osmocom/osmo-bts-amp/datasheets/fischer_wag100.jpg

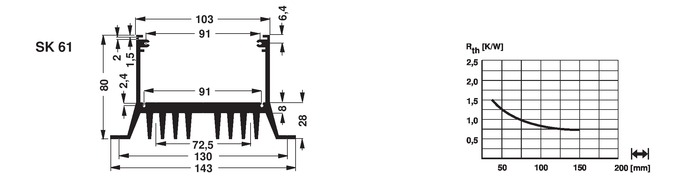
datasheets/fischer_wag100.jpg
