osmocom/osmo-bts-amp/bom/bom.ods

Id | Designator | Package | Quantity | Value | Manufacturer | Supplier | Supplier Ref | SR-Systems | Link
1 | C6, C11, C18 | C-EU_0603 | 3 | 10p / RF |  | SR-Systems | 712-1308-1-ND
2 | C3, C4 | C-EU_0603 | 2 | 15p / RF |  | SR-Systems | 712-1318-1-ND
3 | C5 | C-EU_0603 | 1 | 100p / RF |  | SR-Systems | 712-1310-1-ND
4 | C1, C2, C13, C14, C19 | C-EU_0603 | 5 | 10n |  | SR-Systems | 399-1091-1-ND
5 | C7, C8, C9, C10, C17 | C-EU_0603 | 5 | DNP
6 | C12, C15, C20 | C-EU_0603 | 3 | 100n |  | SR-Systems | 478-1239-1-ND
7 | C16, C21 | C-EU_0805 | 2 | 2.2u |  | Digikey | 587-1286-1-ND
8 | C22, C24, C25, C26 | CPOL-EUSMCA | 4 | 10u / 1ohm |  | Digikey | 478-1751-1-ND
9 | C23 | CPOL-EUSMCA | 1 | 22u / 1ohm |  | Digikey | 718-1304-1-ND
10 | D1, D2, D3, D4, D5 | SOD882 | 5 | PESD5V0F1BL | NXP | Digikey | 568-7344-1-ND |  | http://www.nxp.com/documents/data_sheet/PESD5V0F1BL.pdf
11 | FB1, FB2 | FBEAD_1206 | 2 | 3A |  | Digikey | 240-2412-1-ND
12 | FB3, FB4 | FBEAD_0603 | 2 | 500mA |  | Digikey | 445-6405-1-ND
13 | FLT1 | RDUP_4415 | 1 | RDUP-1710-1785M-1805-1880M-4415-3W-S-CA-J2 | Raditek | sysmocom |  | DNP
14 | FLT2, FLT3 | DCC6C | 2 | B3832 | Epcos | sysmocom |  |  | http://www.epcos.com/inf/40/ds/mc/B3832.pdf
15 | J1, J2 | 2x1 / 2.54 | 2 | '640456-2 | TE | Digikey | A1921-ND
16 | L1 | L-EU_0603 | 1 | 27n |  | Digikey | M8486CT-ND
17 | L2, L3 | L-EU_0603 | 2 | 10n |  | Digikey | M8484CT-ND
18 | R1 | R-EU_0603 | 1 | DNP
19 | ANT, TX_IN, RX_OUT | SMA-F-S-TH | 3 | SMA | Molex | Digikey | WM5537-ND | DNP | http://www.molex.com/pdm_docs/sd/732512201_sd.pdf
20 | RX_OUT_UFL, TX_IN_UFL | HRS_UFL | 2 | U.FL | Hirose | Digikey
21 | U1 | QFN2020_5x5 | 1 | RF3865 | RFMD | sysmocom |  |  | www.rfmd.com/CS/Documents/3865DS.pdf
22 | U2 | ALM32x20 | 1 | ALM32220 | Avago | Farnell |  |  | http://www.avagotech.com/docs/AV02-1146EN
23 | U3 | TO220BV | 1 | MIC29301-5.0WT | Micrel | Digikey | 576-2225-ND |  | http://www.micrel.com/_PDF/mic29150.pdf
24 | RF Shield Frame |  | 1 | 36103255 | Wuerth | Digikey | 732-2489-ND
25 | RF Shield Cover |  | 1 | 36003250 | Wuerth | Digikey | 732-2491-ND
