osmocom/osmo-bts-amp/design/osmo-bts-lna_placement.pdf

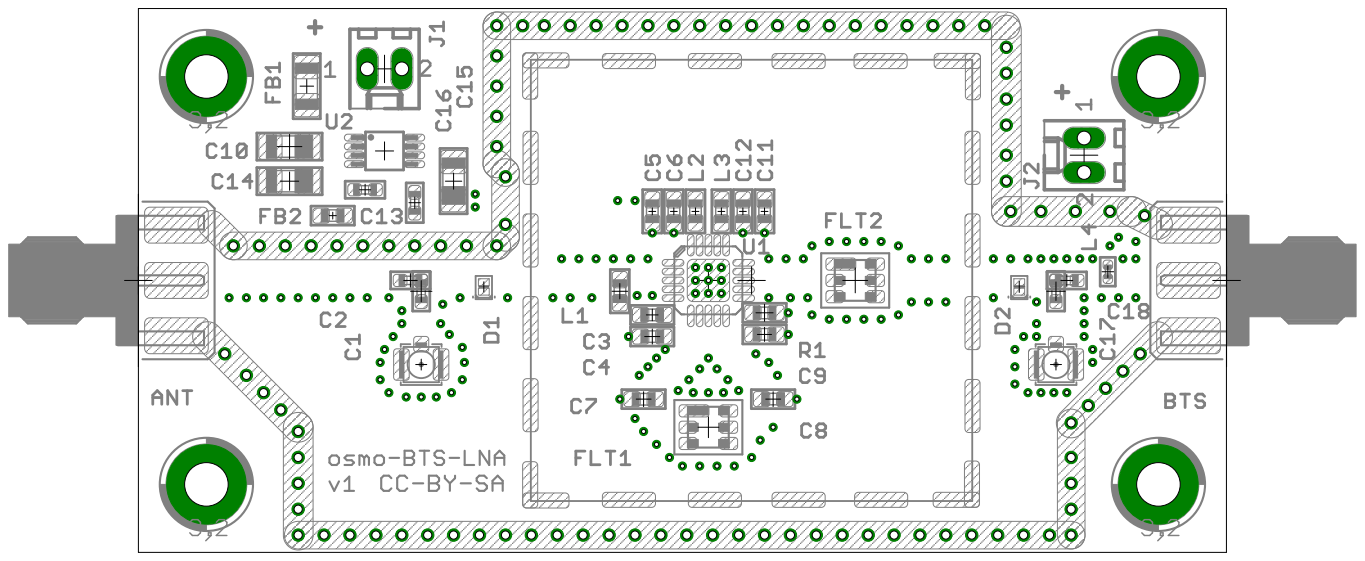
[picture p2: page 1]
