osmocom/osmo-bts-amp/design/osmo-bts-lna_schematic.pdf

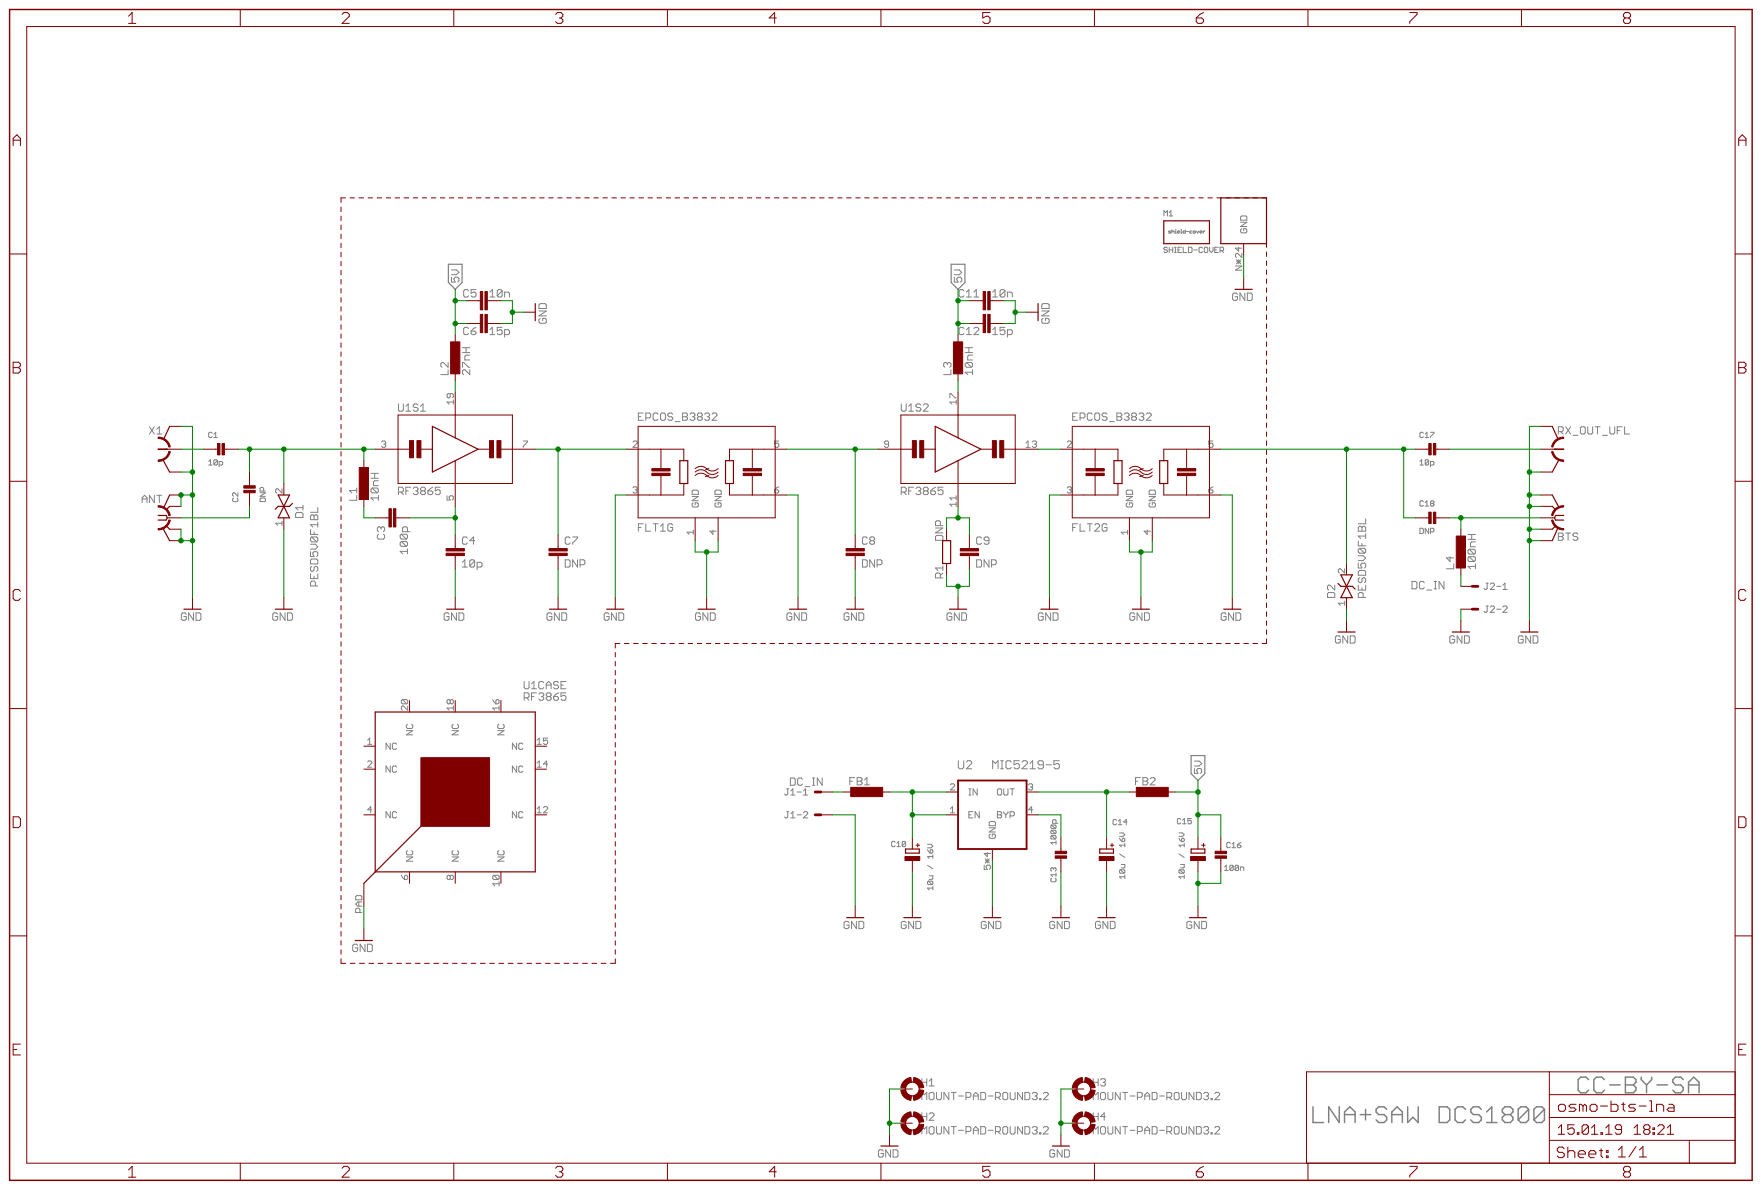
[picture p3: page 1]
