osmocom/osmo-bts-amp/design/frontend_v2.pdf

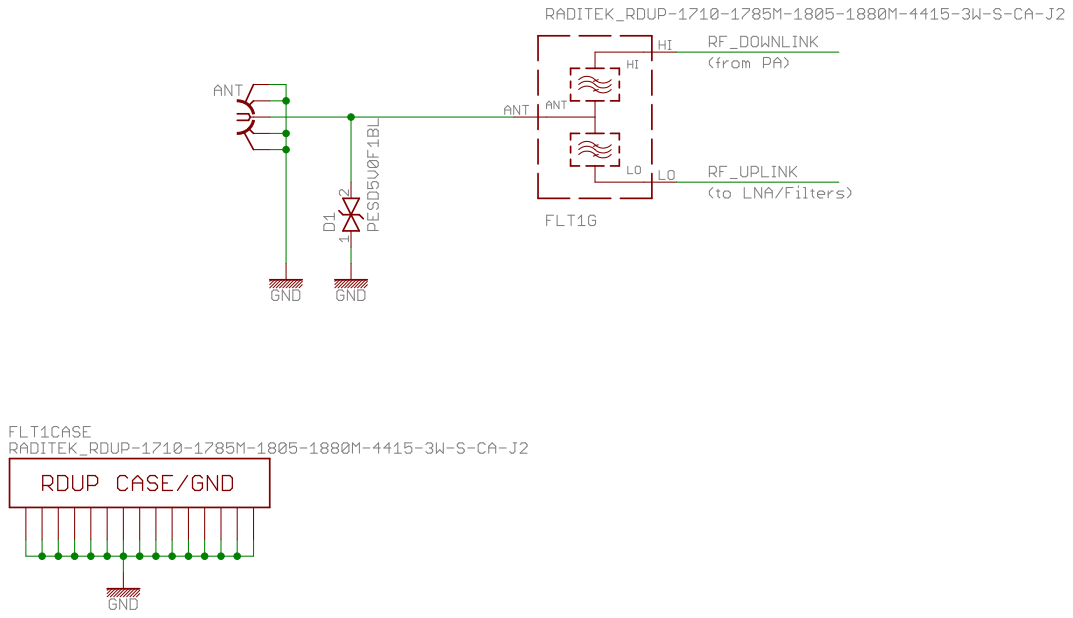
[picture p4: page 1]

20 Sep 2012 09:01:57 f=1.04 /home/eagle/eagle/osmo-bts-amp/design/eagle/frontend_v2.sch (Sheet: 1/4)
