osmocom/osmo-bts-amp/design/frontend_v2_pcb.pdf

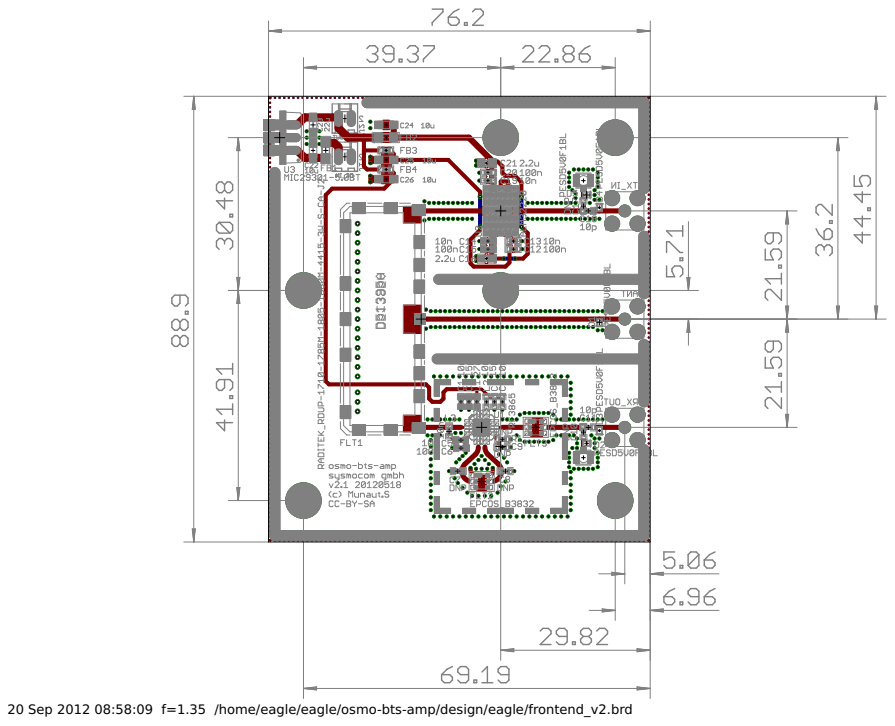
[picture p5: page 1]

20 Sep 2012 08:58:09 f=1.35 /home/eagle/eagle/osmo-bts-amp/design/eagle/frontend_v2.brd
