osmocom/osmo-bts-amp/design/eagle/osmo-bts-lna.brd

## EAGLE design design/eagle/osmo-bts-lna.brd (2019-01-15)

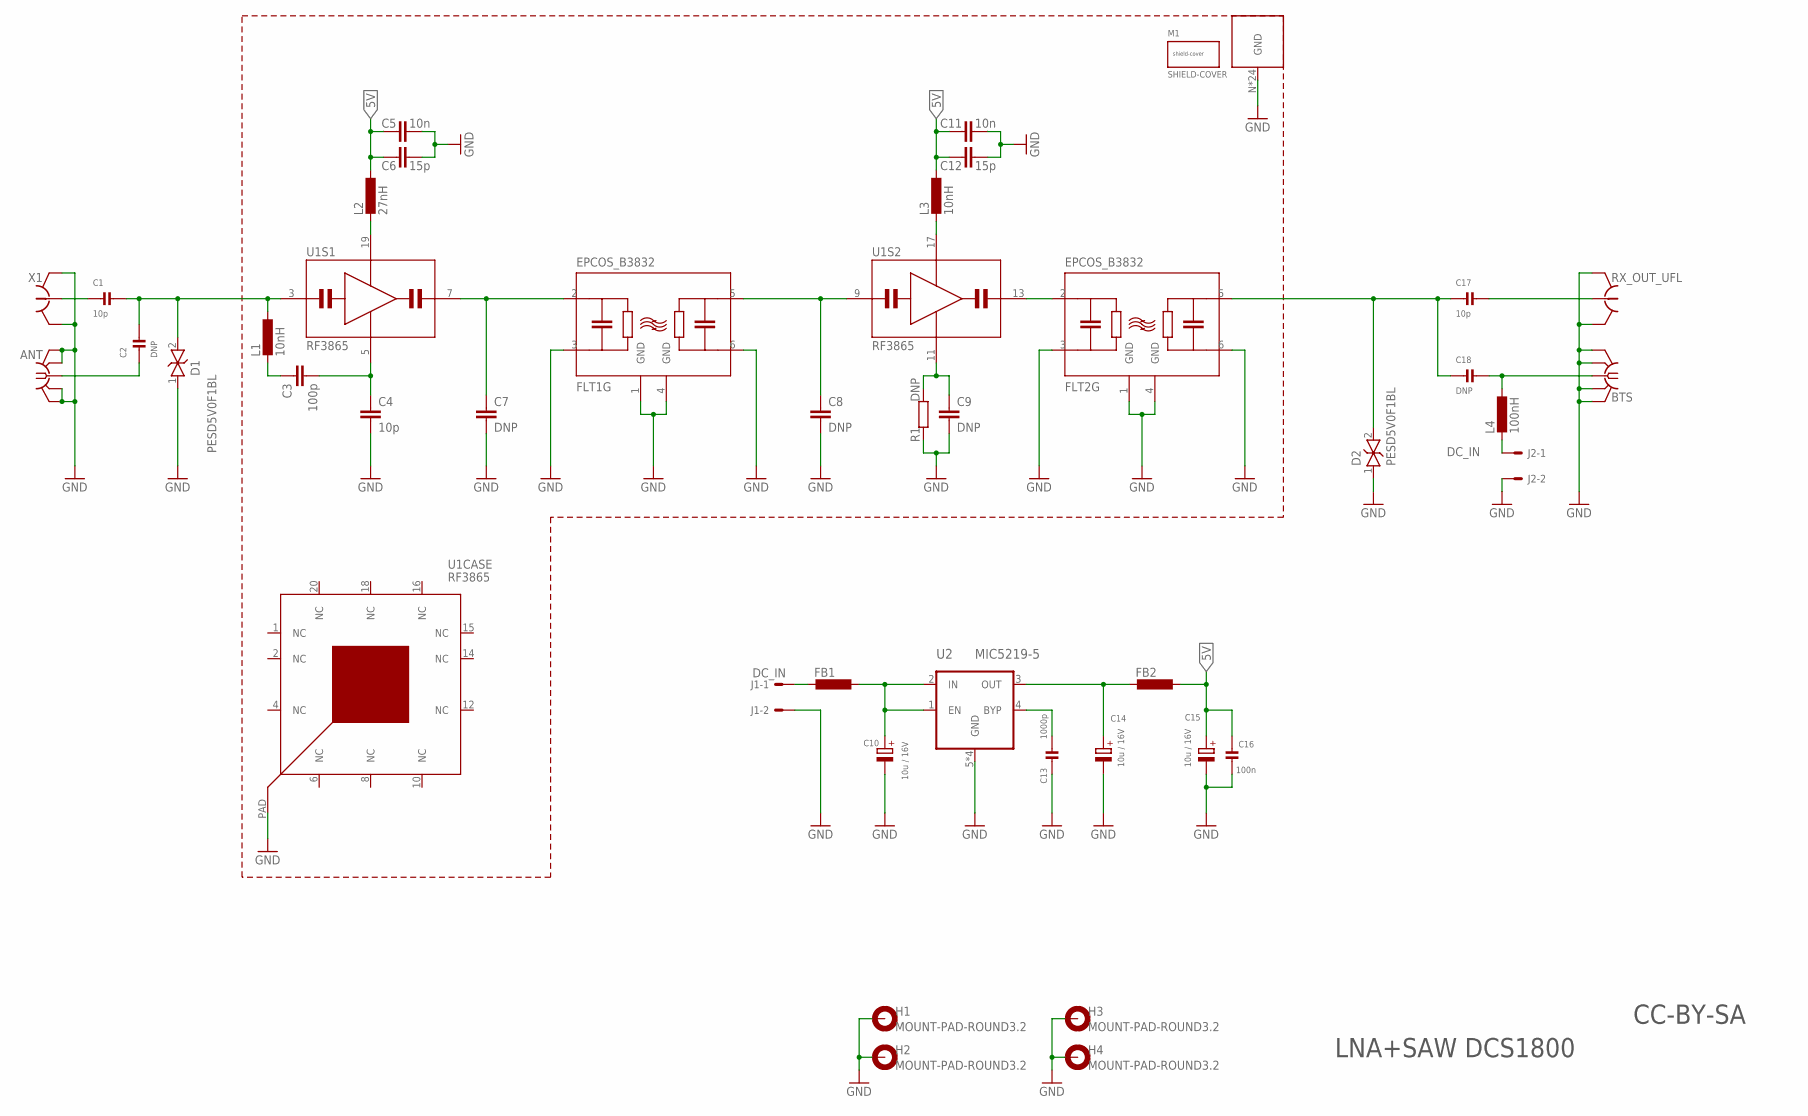
[picture p6: schematic osmo-bts-lna.sch]

Parts:
ANT: SMA-F-S-EDGE; MANUFACTURERPARTNUMBER UNKNOWN MANUFACTURER PART NUMBER
BTS: SMA-F-S-EDGE; MANUFACTURERPARTNUMBER UNKNOWN MANUFACTURER PART NUMBER
C1, C17: 10p; _0603; MANUFACTURERPARTNUMBER C0603C100J5GACTU
C2, C18: DNP; _0603; MANUFACTURERPARTNUMBER UNKNOWN MANUFACTURER PART NUMBER
C3: 100p; 0603; MANUFACTURERPARTNUMBER 06035A101FAT2A
C4: 10p; 0603; MANUFACTURERPARTNUMBER C0603C100J5GACTU
C5, C11: 10n; 0603; MANUFACTURERPARTNUMBER GCM188R72A103KA37D
C6, C12: 15p; 0603; MANUFACTURERPARTNUMBER CL10C150JB8NCNC
C7, C8, C9: DNP; 0603; MANUFACTURERPARTNUMBER UNKNOWN MANUFACTURER PART NUMBER
C10, C14, C15: 10u / 16V; CPOL1206; MANUFACTURERPARTNUMBER CL21A106KOCLRNC
C13: 1000p; _0603; MANUFACTURERPARTNUMBER CC0402KRX7R7BB102
C16: 100n; _0603; MANUFACTURERPARTNUMBER CL10B104KO8NNNC
D1, D2: PESD5V0F1BL; SOD882; MANUFACTURERPARTNUMBER PESD5V0F1BL,315
FB1: FBEAD_1206; 1206; MANUFACTURERPARTNUMBER HZ0805D102R-10
FB2: INDUCTOR0603; 0603; MANUFACTURERPARTNUMBER HZ0805D102R-10
FLT1, FLT2: EPCOS_B3832; DCC6C; MANUFACTURERPARTNUMBER UNKNOWN MANUFACTURER PART NUMBER
H1, H2, H3, H4: MOUNT-PAD-ROUND3.2; 3,2-PAD; MANUFACTURERPARTNUMBER UNKNOWN MANUFACTURER PART NUMBER
J1, J2: DC_IN; 6410-02; MANUFACTURERPARTNUMBER UNKNOWN MANUFACTURER PART NUMBER
L1, L3: 10nH; 0603; MANUFACTURERPARTNUMBER PM0603-10NJ-RC
L2: 27nH; 0603; MANUFACTURERPARTNUMBER PM0603-27NJ-RC
L4: 100nH; _0402; MANUFACTURERPARTNUMBER LQG15HHR10J02D
R1: DNP; 0603; MANUFACTURERPARTNUMBER UNKNOWN MANUFACTURER PART NUMBER
RX_OUT_UFL: HRS_UFL; MANUFACTURERPARTNUMBER U.FL-R-SMT(01)
SHLD1: SHIELD-BMI-S-204; BMI-S-204; MANUFACTURERPARTNUMBER BMI-S-204-F
U1: RF3865; QFN20_5X5_PAD; MANUFACTURERPARTNUMBER UNKNOWN MANUFACTURER PART NUMBER
U2: MIC5219-5; MSOP8; MANUFACTURERPARTNUMBER MIC5219-5.0YMM
X1: HRS_UFL; MANUFACTURERPARTNUMBER U.FL-R-SMT(01)

Connections:
5V: C5.1, C6.1, C11.1, C12.1, C15.+, C16.1, FB2.2, L2.1, L3.1
DC_IN: FB1.1, J1.1
DC_IN_FLT: C10.+, FB1.2, U2.1 (EN), U2.2 (IN)
GND: ANT.BG1 (GND), ANT.BG2 (GND), ANT.TG1 (GND), ANT.TG2 (GND), BTS.BG1 (GND), BTS.BG2 (GND), BTS.TG1 (GND), BTS.TG2 (GND), C4.2, C5.2, C6.2, C7.2, C8.2, C9.2, C10.-, C11.2, C12.2, C13.2, C14.-, C15.-, C16.2, D1.1, D2.1, FLT1.1 (GND), FLT1.3 (IN_GND), FLT1.4 (GND), FLT1.6 (OUT_GND), FLT2.1 (GND), FLT2.3 (IN_GND), FLT2.4 (GND), FLT2.6 (OUT_GND), H1.B3,2, H2.B3,2, H3.B3,2, H4.B3,2, J1.2, J2.2, R1.1, RX_OUT_UFL.GND@1 (GND), RX_OUT_UFL.GND@2 (GND), SHLD1.N, SHLD1.NNE, SHLD1.NNE1, SHLD1.NNE2, SHLD1.NNE4, SHLD1.NNE5, SHLD1.NNW, SHLD1.S, SHLD1.S1, SHLD1.S2, SHLD1.S3, SHLD1.S4, SHLD1.S5, SHLD1.S6, SHLD1.S7, SHLD1.S8, SHLD1.S9, SHLD1.SSE, SHLD1.SSW, SHLD1.SSW1, SHLD1.SSW2, SHLD1.SSW3, SHLD1.SSW4, SHLD1.SSW5, U1.PAD (CASE_GND), U2.5 (GND), U2.6 (GND), U2.7 (GND), U2.8 (GND), X1.GND@1 (GND), X1.GND@2 (GND)
unnamed: L2.2, U1.19 (VDD)
unnamed: ANT.C (1), C2.1
unnamed: C13.1, U2.4 (BYP)
unnamed: C3.1, L1.2
unnamed: C3.2, C4.1, U1.5 (AC_GND)
unnamed: C9.1, R1.2, U1.11 (AC_GND)
unnamed: C1.1, X1.SIG (1)
unnamed: C17.2, RX_OUT_UFL.SIG (1)
unnamed: C17.1, C18.1, D2.2, FLT2.5 (OUT)
unnamed: L3.2, U1.17 (VDD)
unnamed: J2.1, L4.2
unnamed: C14.+, FB2.1, U2.3 (OUT)
RF_UPLINK: C1.2, C2.2, D1.2, L1.1, U1.3 (RF_IN)
RF_UPLINK_IS_IN: C8.1, FLT1.5 (OUT), U1.9 (RF_IN)
RF_UPLINK_IS_OUT: C7.1, FLT1.2 (IN), U1.7 (RF_OUT)
RF_UPLINK_LNA_OUT: FLT2.2 (IN), U1.13 (RF_OUT)
RF_UPLINK_OUT: BTS.C (1), C18.2, L4.1

Notes on the sheet:
LNA+SAW DCS1800
CC-BY-SA

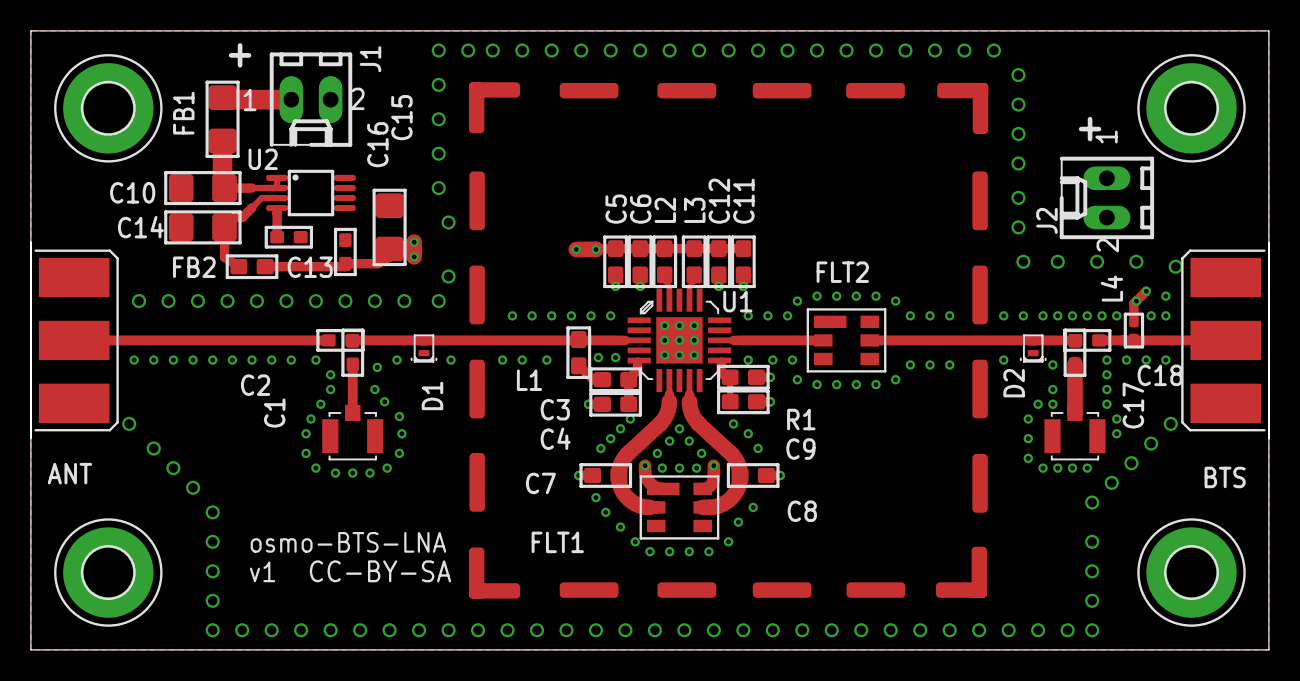
[picture p7: board osmo-bts-lna.brd from above]

Board: 4 copper layers, 80.0 x 40.0 mm, 42 parts (0 on the bottom side), 21 nets.
