osmocom/osmo-bts-amp/design/eagle/pa_only_900.brd

## EAGLE design design/eagle/pa_only_900.brd (2012-10-22)

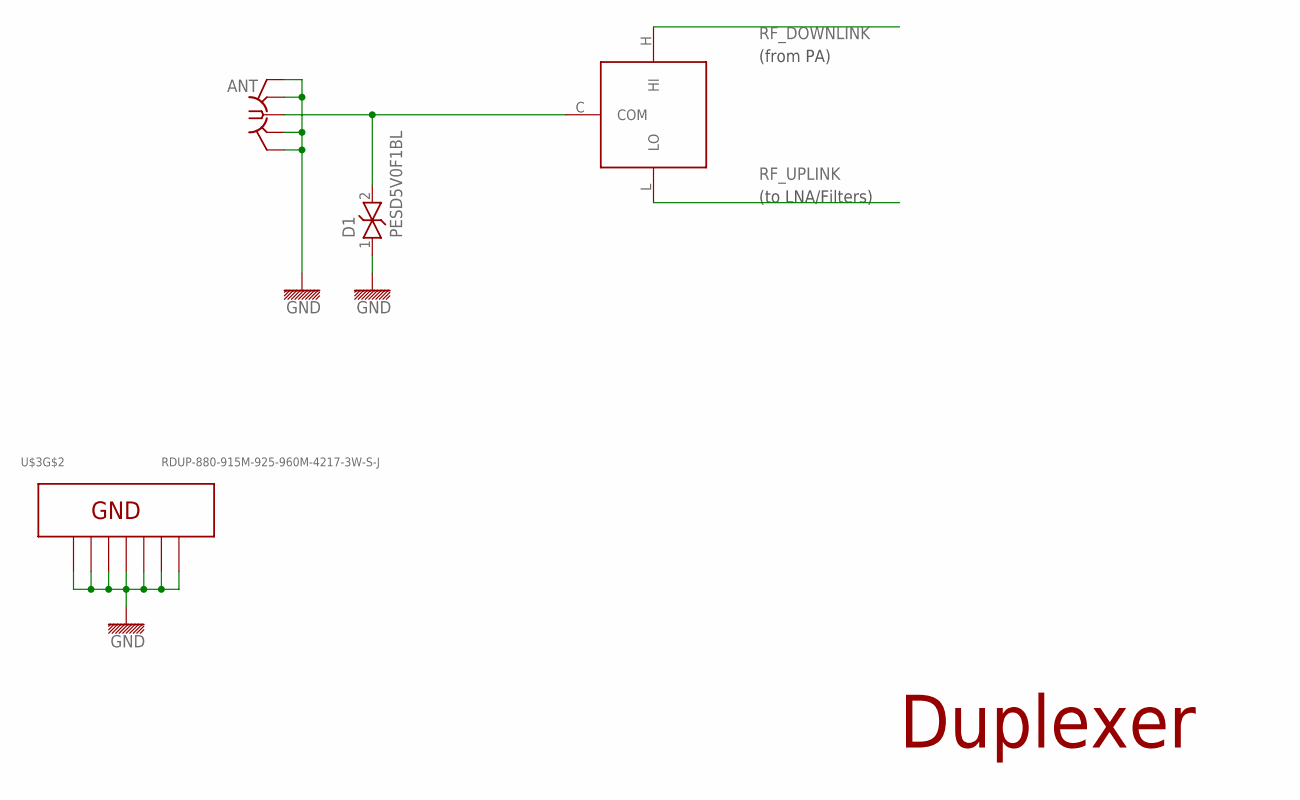
[picture p8: schematic pa_only_900.sch, sheet 1]

Parts:
ANT: SMA-F-S-TH
D1: PESD5V0F1BL; SOD882
U$3: RDUP-880-915M-925-960M-4217-3W-S-J; RADITEK_4217

Connections:
GND: ANT.G1 (GND), ANT.G2 (GND), ANT.G3 (GND), ANT.G4 (GND), D1.1, U$3.G1, U$3.G2, U$3.G3, U$3.G4, U$3.G5, U$3.G6, U$3.G7; also elsewhere on the board
RF_ANT: ANT.C (1), D1.2, U$3.C (COM)
RF_DOWNLINK: U$3.H (HI); also elsewhere on the board
RF_UPLINK: U$3.L (LO); also elsewhere on the board

Notes on the sheet:
(from PA)
(to LNA/Filters)
Duplexer

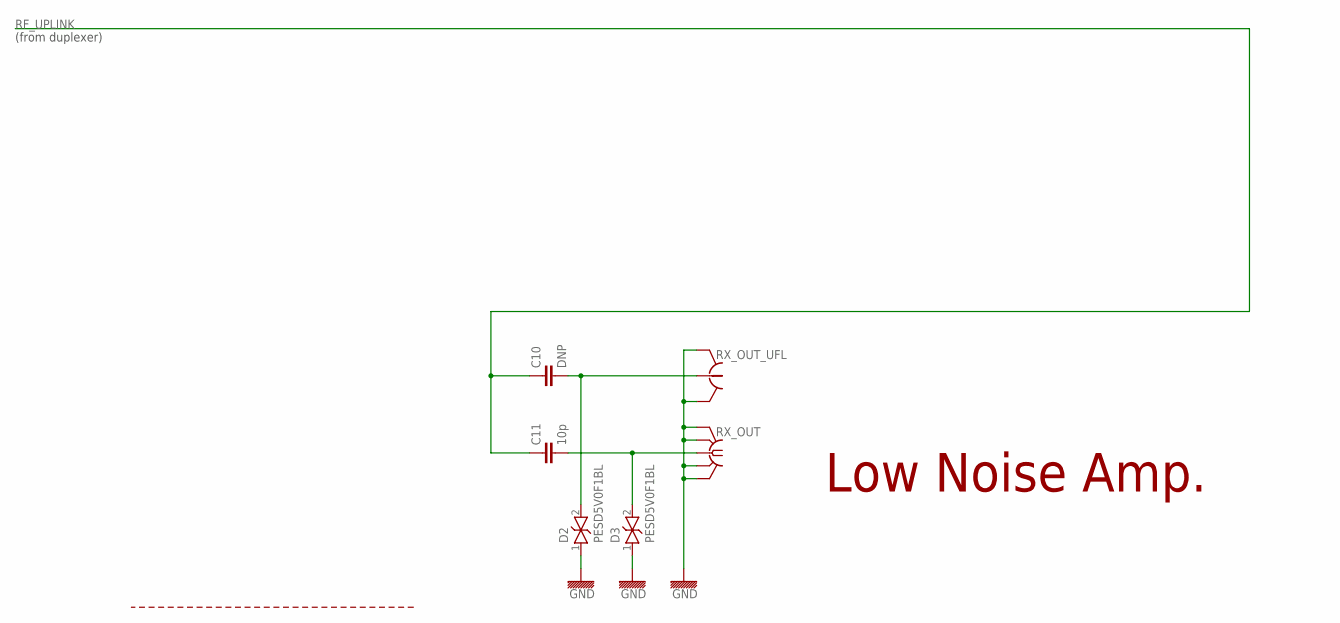
[picture p9: schematic pa_only_900.sch, sheet 2]

Parts:
C10: DNP; 0603
C11: 10p; 0603
D2, D3: PESD5V0F1BL; SOD882
RX_OUT: SMA-F-S-TH
RX_OUT_UFL: HRS_UFL

Connections:
GND: D2.1, D3.1, RX_OUT.G1 (GND), RX_OUT.G2 (GND), RX_OUT.G3 (GND), RX_OUT.G4 (GND), RX_OUT_UFL.GND@1 (GND), RX_OUT_UFL.GND@2 (GND); also elsewhere on the board
unnamed: C10.2, D2.2, RX_OUT_UFL.SIG (1)
RF_UPLINK: C10.1, C11.1; also elsewhere on the board
RF_UPLINK_OUT: C11.2, D3.2, RX_OUT.C (1)

Notes on the sheet:
(from duplexer)
Low Noise Amp.

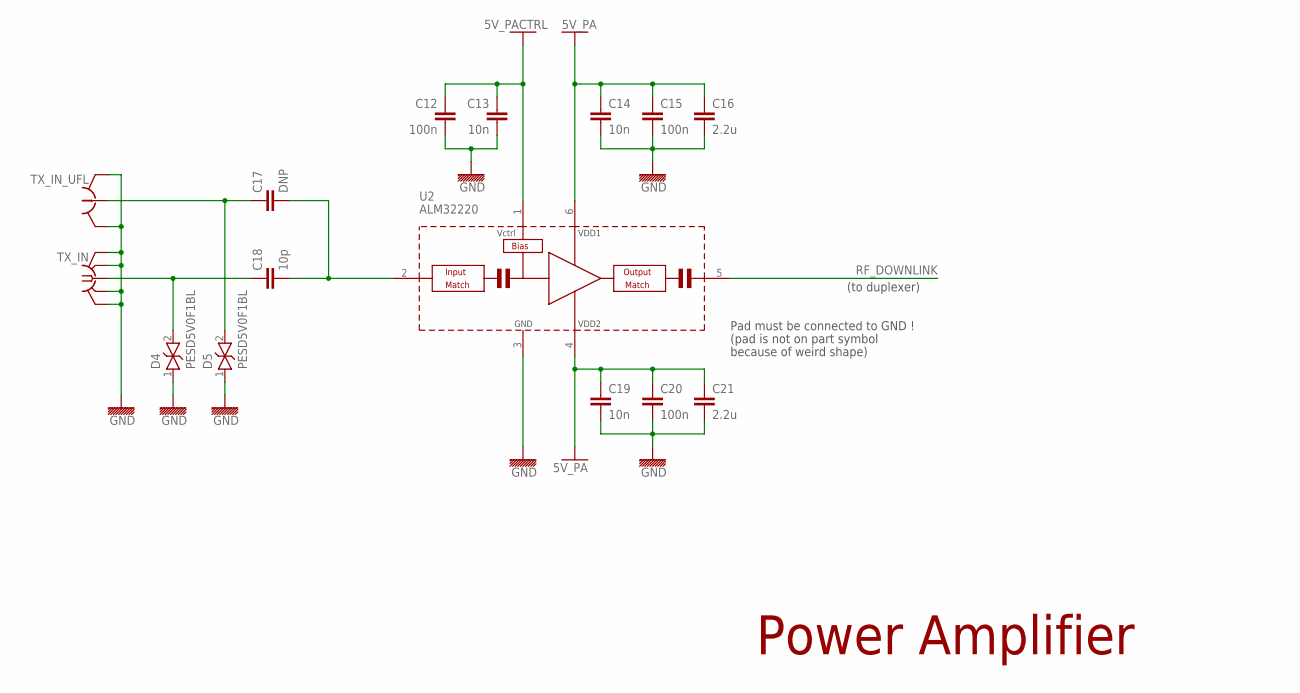
[picture p10: schematic pa_only_900.sch, sheet 3]

Parts:
C12, C15, C20: 100n; 0603
C13, C14, C19: 10n; 0603
C16, C21: 2.2u; 0805
C17: DNP; 0603
C18: 10p; 0603
D4, D5: PESD5V0F1BL; SOD882
TX_IN: SMA-F-S-TH
TX_IN_UFL: HRS_UFL
U2: ALM32220; ALM32X20

Connections:
5V_PA: C14.1, C15.1, C16.1, C19.1, C20.1, C21.1, U2.4 (VDD2), U2.6 (VDD1); also elsewhere on the board
5V_PACTRL: C12.1, C13.1, U2.1 (VCTRL); also elsewhere on the board
GND: C12.2, C13.2, C14.2, C15.2, C16.2, C19.2, C20.2, C21.2, D4.1, D5.1, TX_IN.G1 (GND), TX_IN.G2 (GND), TX_IN.G3 (GND), TX_IN.G4 (GND), TX_IN_UFL.GND@1 (GND), TX_IN_UFL.GND@2 (GND), U2.3 (GND); also elsewhere on the board
unnamed: C18.1, D4.2, TX_IN.C (1)
unnamed: C17.2, C18.2, U2.2 (RF_IN)
unnamed: C17.1, D5.2, TX_IN_UFL.SIG (1)
RF_DOWNLINK: U2.5 (RF_OUT); also elsewhere on the board

Notes on the sheet:
(to duplexer)
Pad must be connected to GND !
(pad is not on part symbol
because of weird shape)
Power Amplifier

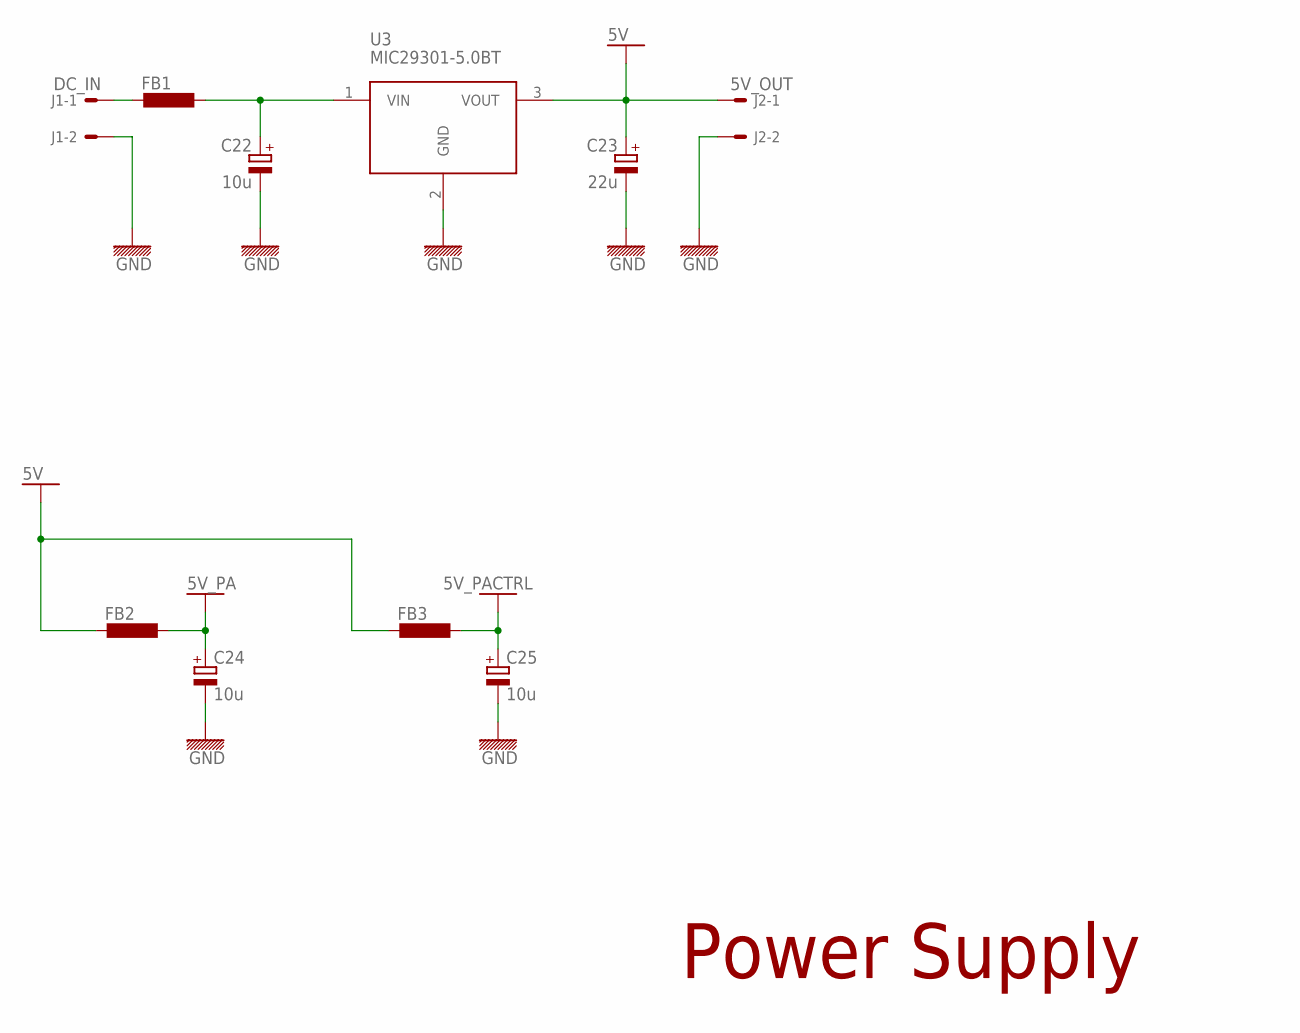
[picture p11: schematic pa_only_900.sch, sheet 4]

Parts:
C22, C24, C25: 10u; SMC_A
C23: 22u; SMC_A
FB1, FB2: FBEAD_1206; 1206
FB3: FBEAD_0603; 0603
J1: DC_IN; 6410-02
J2: 5V_OUT; 6410-02
U3: MIC29301-5.0BT; TO220BV

Connections:
5V: C23.+, FB2.1, FB3.1, J2.1, U3.3 (VOUT)
5V_PA: C24.+, FB2.2; also elsewhere on the board
5V_PACTRL: C25.+, FB3.2; also elsewhere on the board
DC_IN: FB1.1, J1.1
DC_IN_FLT: C22.+, FB1.2, U3.1 (VIN)
GND: C22.-, C23.-, C24.-, C25.-, J1.2, J2.2, U3.2 (GND); also elsewhere on the board

Notes on the sheet:
Power Supply

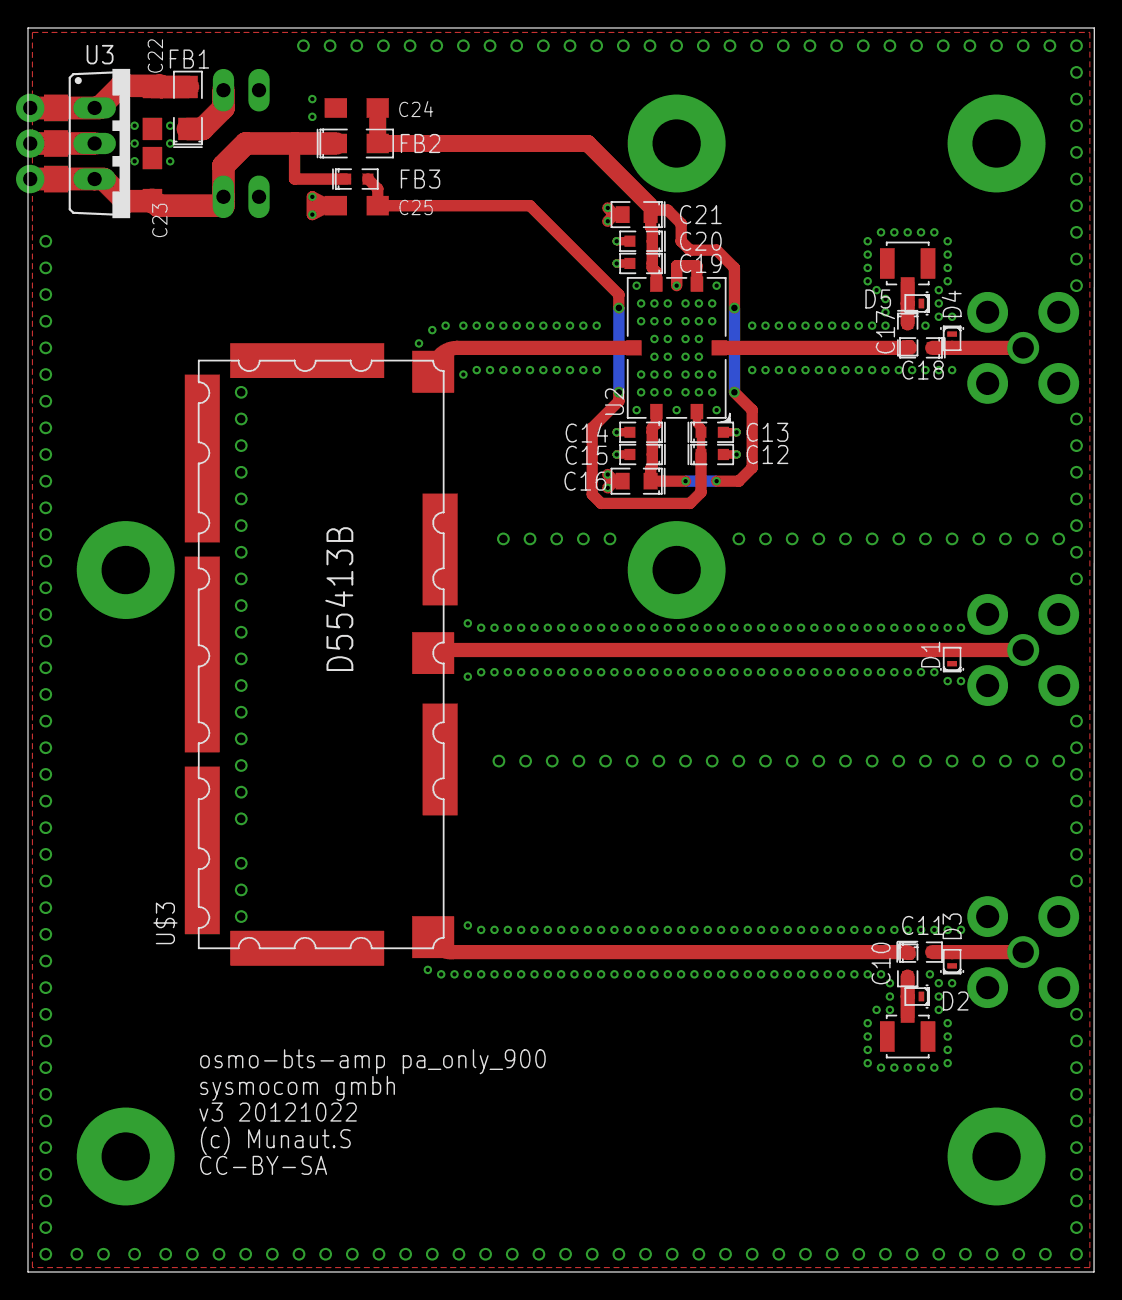
[picture p12: board pa_only_900.brd from above]

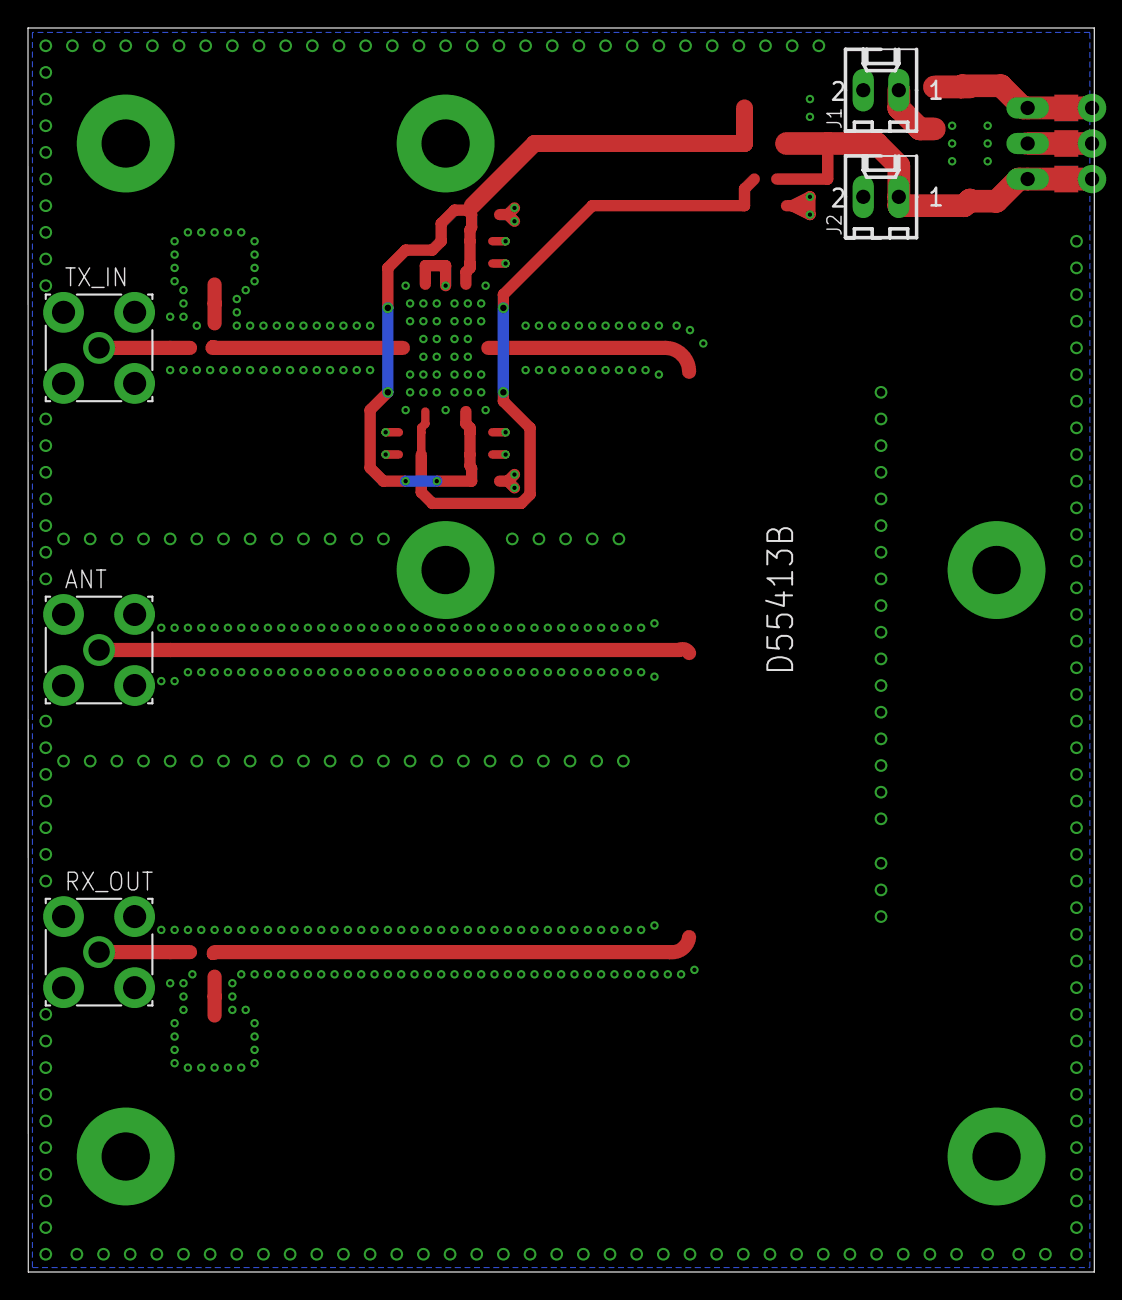
[picture p13: board pa_only_900.brd from below]

Board: 2 copper layers, 76.2 x 88.9 mm, 34 parts (5 on the bottom side), 14 nets.
