osmocom/osmo-bts-amp/(commit log)

2012-01-11 initial import of mini-amp project
    [frontend_v2.GBL, frontend_v2.GBO, frontend_v2.GBP, frontend_v2.GBS, frontend_v2.GTL, frontend_v2.GTO, frontend_v2.GTP, frontend_v2.GTS]
2012-01-11 add datasheet of epcos filter
2012-05-17 add fischer case drawing
2012-05-18 design: Remove sch & brd because they were binaries from Eagle v5.x
    [frontend_v2.brd, frontend_v2.sch]
2012-05-18 design: Import original design as Eagle 6.x XML format
    This is pretty much the first manufactured board. (just a couple
    of solder mask fixes)
    [frontend_v2.brd, frontend_v2.sch]
2012-05-18 design: Major revision of the PCB to fit into enclosure
    [frontend_v2.brd, frontend_v2.sch]
2012-05-18 design: Move the outside holes closer to their optimal position
    According to the WAG100 datasheet they should be 36.25 mm from the center
    axis. Now they are 36.2 mm from the center axis which should work fine.
    [frontend_v2.brd]
2012-05-19 design: Make the traces 40 mil wide with 12 mil GND separaton
    This should keep a ~ 55 ohm impedance (close enough)
    [frontend_v2.brd]
2012-05-19 import partlist and BOM
    [bom.ods]
2012-05-21 BOM: use 25x25 mm shielding cover, not 30x30
    The BOM contained the wrong part numbers for the shielding cover
    [bom.ods]
2012-09-20 add more recent schematics + gerber renderings
2012-10-22 move dimensions a bit closer to the PCB for print view
    (allows larger scaling on A4 printout)
    [frontend_v2.brd]
2012-10-22 for pa_only_1800 as copy of frontend_v2
    [pa_only_1800.brd, pa_only_1800.sch]
2012-10-22 add a PA-only version without LNA for DCS 1800
    [pa_only_1800.brd, pa_only_1800.sch]
2012-10-22 Start a PA-only version for GSM 900
    [pa_only_900.brd, pa_only_900.sch]
2012-10-22 schematics / gerber of 900 MHz PA-only version
    [pa_only_900.brd, pa_only_900.sch]
2014-06-30 add current ALM data sheets and application note
2019-01-15 bts-lna: add/update design files, add schema + PCB as pdf
    [osmo-bts-lna.brd, osmo-bts-lna.sch]
